serikov1/AutomaticWateringSystem/README.md

# Автоматическая система полива комнатных растений

* [Описание проекта](#chapter-0)
* [Материалы и компоненты](#chapter-1)
* [Схема подключения](#chapter-2)
* [Код проекта](#chapter-3)
* [Тестирование](#chapter-4)
* [Инструкция по эксплуатации (скачать)](#chapter-5)

## Описание проекта
Особенности:
- Возможность полива 2 видов растений с различным потреблением влаги
- Индивидуальная настройка пользователем периода и времени работы системы полива
- Дисплей с отображением пользовательских настроек
- Хранение настроек в энергонезависимой памяти
- Управление и настройка энкодером и кнопкой

## Материалы и компоненты

| Компоненты | шт | цена, руб|
| --- |:--:|:---:|
| Пластиковый (PLA) корпус, напечатанный на 3D принтере | 1  | 55 |
| Помпа водяная | 2  | 500 |
| Экран жидкокристаллический (lcd 1602 I2C) | 1  | 200 |
| Энкодер (HC11) | 1  | 100 |
| Микроконтроллер (Arduino Nano ATmega328P) | 1  | 200 |
| Транзистор полевой (IRF1407) | 2  | 20 |
| Резистор 10кΩ | 2  | 10 |
| Резистор 200Ω | 2  | 10 |
| Диод 1N5408 | 2  | 10 |
| Конденсатор электролитический 470uF | 2  | 10 |
| Конденсатор керамический 0,1uF | 1  | 10 |
| Разъем micro-usb | 1  | 50 |
| Плата печатная | 1  | 50 |
| | |Итог: 1225|

## Схема подключения модулей
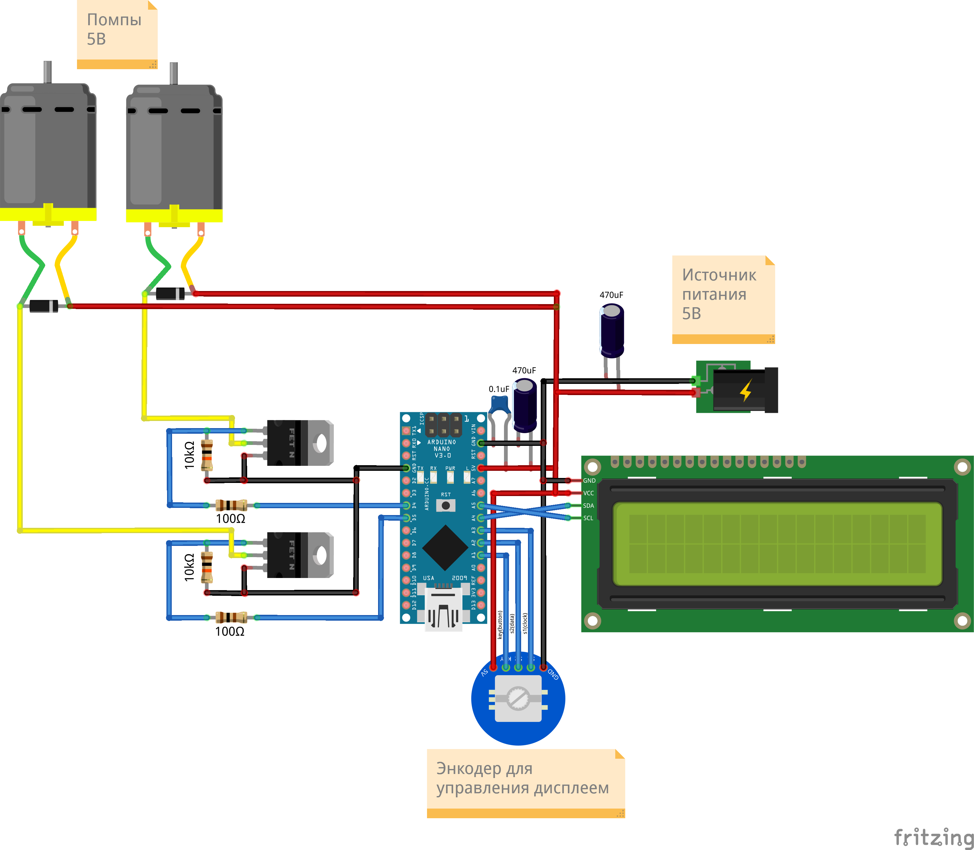
[picture p1: pictures/scheme.png]
SCHEME


### Код проекта смотрите по [ссылке](https://github.com/serikov1/AutomaticWateringSystem/tree/main/src)

### Результаты тестирования (протоколы испытыний) смотрите по [ссылке](https://github.com/serikov1/AutomaticWateringSystem/tree/main/presentation)

### Руководство по эксплуатации обязательно(!) к прочтению по [ссылке](https://github.com/serikov1/AutomaticWateringSystem/raw/main/manual/Automatic%20Watering%20System%20Manual.pdf)
