serikov1/AutomaticWateringSystem/presentation/perfomance.pptx

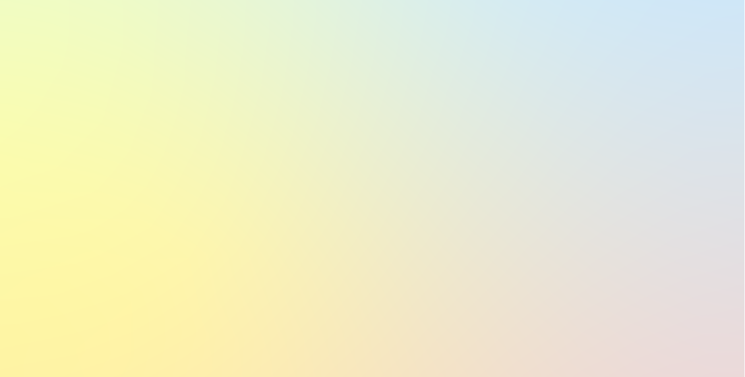
[picture p2: figure]

План создания продукта

Автоматический полив растений

Группа: Б03-102 Студент: Сериков Василий

## Slide 2

Проблемы

1.

Часто забываем поливать домашние растения

2.

Имеем большое количество различных растений

3.

Долгое время находимся вне дома

## Slide 3

Решения

1.

Полив настроенный на определенные промежутки время

2.

Поддержка полива нескольких различных растений

3.

Питание от блока 5В,
использование любой емкости с водой

## Slide 4

Схема устройства

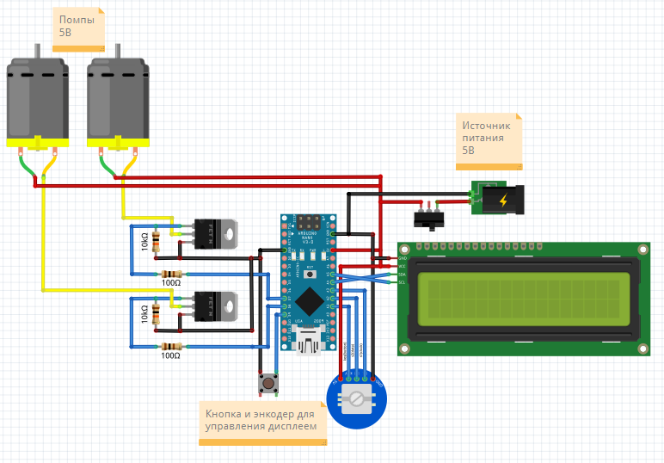
[picture p3: figure]

## Slide 5

Стоимость элементов

1. Arduino Nano ATmega328P – 300 руб.

2. Помпа водяная 2шт.– 500 руб.

3. ЖК экран lcd1602 I2C– 300 руб.

4. Энкодер HC11 – 120 руб.

5. Кнопка тактовая – 9 руб.

6. Mosfet IRF1407 2шт. – 40 руб.

7. Резисторы 10кΩ, 200Ω по 2шт. ~ 10 руб.

8. Переключатель двухпозиционный – 40 руб.

9. Корпус пластиковый ~ 20 руб.

Σ = 1339 руб.

## Slide 6

График работы

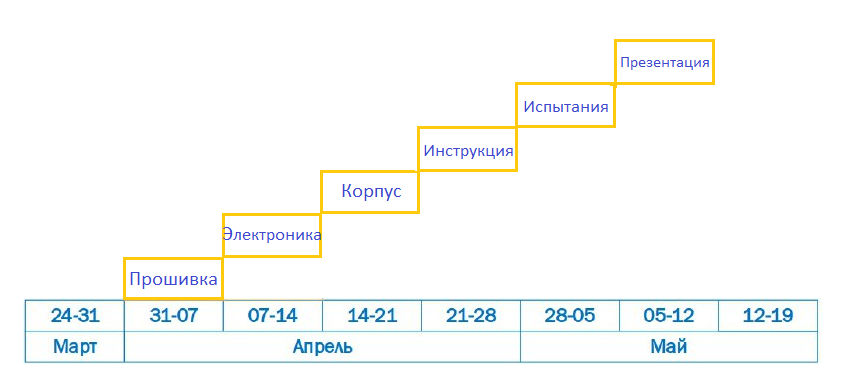
[picture p4: figure]

## Slide 7

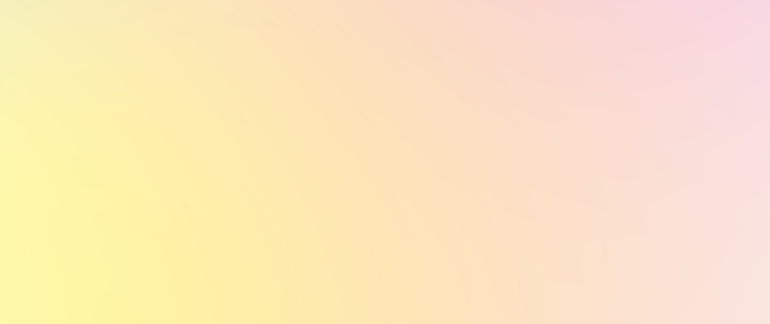
[picture p5: figure]

Спасибо за внимание

Ссылка на репозиторий

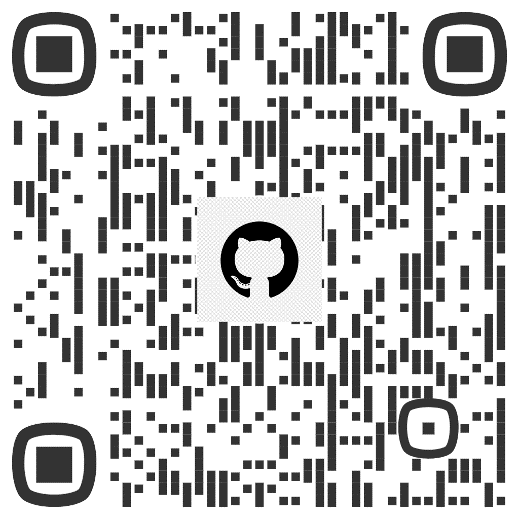
[picture p6: figure]
