serikov1/AutomaticWateringSystem/presentation/протокол испытаний №3.docx

г. Долгопрудный “19” мая 2023 г.

ПРОТОКОЛ ИСПЫТАНИЙ №3

на отказоустойчивость автоматической системы полива

1. Объект: система автоматического полива
2. Заказчик испытания: Сериков Василий
3. Дата изготовления: 7.04.2023 г.
4. Дата испытаний: 4.04.2023 г. – 15.04.2023 г.
5. Число образцов: 1 штука
6. Требования по отказоустойчивости: 10 дней
7. Условия проведения испытаний температурный режим: 25 °C
8. Число циклов работы системы: 10 по 24 часа
9. Фактическое время работы: 10 дней

Выводы: система автоматического полива справилась с испытанием работы в течении 10 дней.

Независимый эксперт Потылицын Иван
