serikov1/AutomaticWateringSystem/presentation/протокол испытаний №1.docx

г. Долгопрудный “15” мая 2023 г.

ПРОТОКОЛ ИСПЫТАНИЙ №1

на отказоустойчивость автоматической системы полива

1. Объект: система автоматического полива
2. Заказчик испытания: Сериков Василий
3. Дата изготовления: 7.04.2023 г.
4. Дата испытаний: 14.04.2023 г. – 21.04.2023 г.
5. Число образцов: 1 штука
6. Требования по отказоустойчивости: 24, 48 часа
7. Условия проведения испытаний температурный режим: 25 °C
8. Число циклов работы системы: 3
9. Фактическое время работы: 24 часа

Выводы: Система автоматического полива не справилась с испытанием работы 48 часа, но справилась с 24 часами работы.

Независимый эксперт Шувайникова Татьяна.
