serikov1/AutomaticWateringSystem/presentation/протокол испытаний №2.docx

г. Долгопрудный “15” мая 2023 г.

ПРОТОКОЛ ИСПЫТАНИЙ №2

на отказоустойчивость автоматической системы полива

1. Объект: система автоматического полива
2. Заказчик испытания: Сериков Василий
3. Дата изготовления: 7.04.2023 г.
4. Дата испытаний: 22.04.2023 г. – 2.05.2023 г.
5. Число образцов: 1 штука
6. Требования по отказоустойчивости: 24, 48, 72 часа
7. Условия проведения испытаний температурный режим: 25 °C
8. Число циклов работы системы: 3
9. Фактическое время работы: 24, 48, 72 часа

Выводы: Система автоматического полива справилась с испытанием работы 24, 48, 72 часа

Независимый эксперт Сериков Алексей.
