serikov1/AutomaticWateringSystem/presentation/first protection.pptx

Презентация макета

Автоматический полив растений

Группа: Б03-102 Студент: Сериков Василий

## Slide 2

Выполненные задачи

1.

Разработка прошивки

2.

Создание корпуса

3.

Сборка схемы

## Slide 3

Оставшиеся задачи

1.

Доработка корпуса

2.

Написание инструкции

3.

Тестирование

## Slide 4


Спасибо за внимание

Ссылка на репозиторий
