serikov1/AutomaticWateringSystem/body model/fourth model/3.png

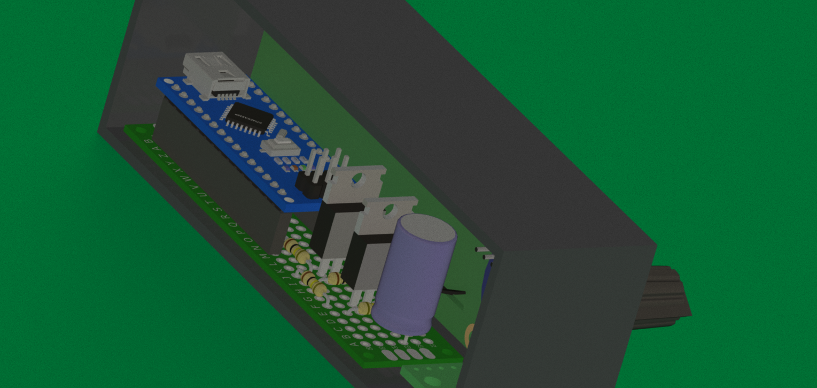
body model/fourth model/3.png
