serikov1/AutomaticWateringSystem/body model/fourth model/4.png

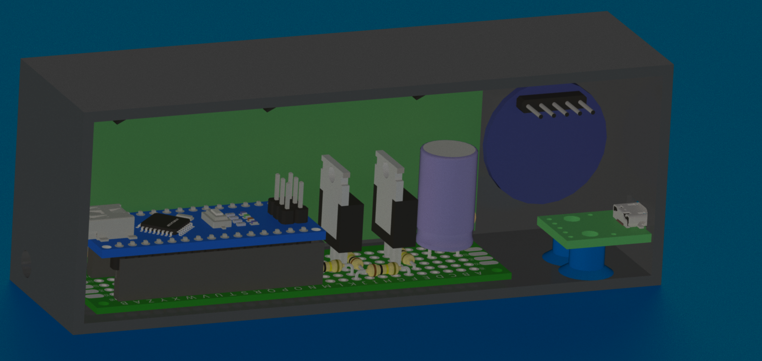
body model/fourth model/4.png
