serikov1/AutomaticWateringSystem/body model/fourth model/5.png

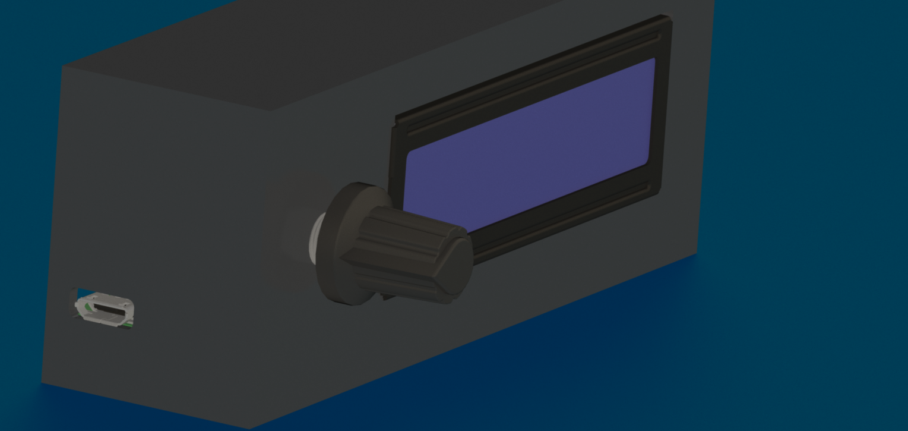
body model/fourth model/5.png
