serikov1/AutomaticWateringSystem/body model/fourth model/6.png

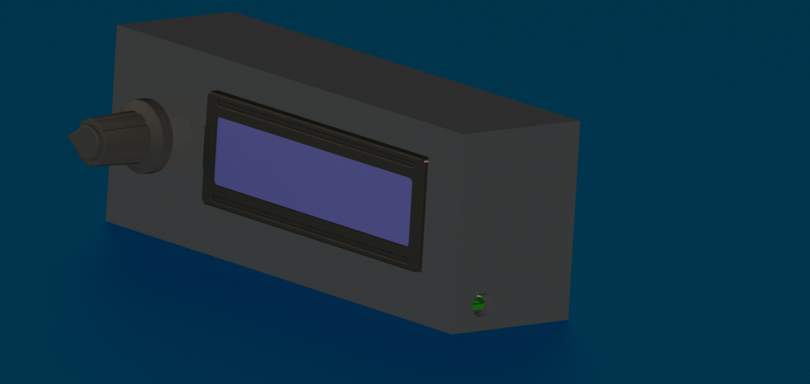
body model/fourth model/6.png
