serikov1/AutomaticWateringSystem/body model/fourth model/7.png

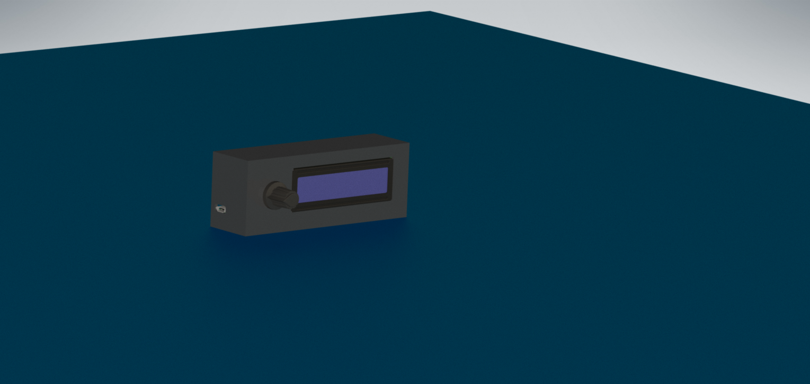
body model/fourth model/7.png
