serikov1/AutomaticWateringSystem/body model/fourth model/8.png

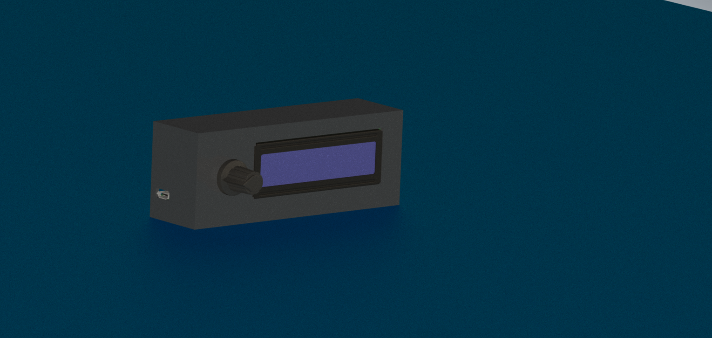
body model/fourth model/8.png
