serikov1/AutomaticWateringSystem/body model/fourth model/9.png

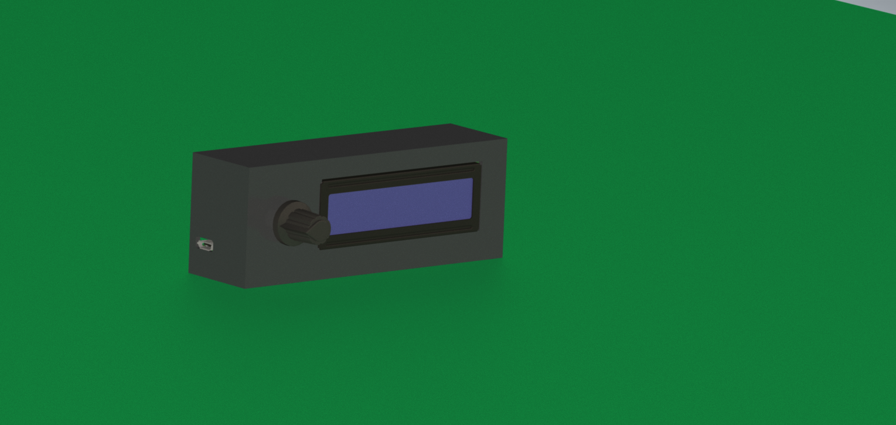
body model/fourth model/9.png
