serikov1/AutomaticWateringSystem/body model/fourth model/10.png

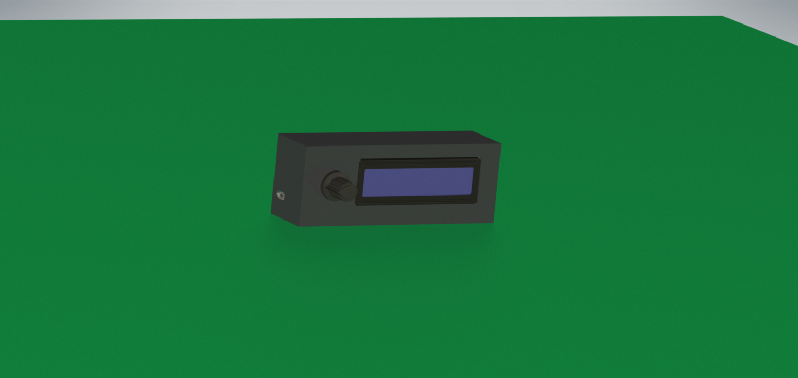
body model/fourth model/10.png
