serikov1/AutomaticWateringSystem/body model/fourth model/body model 2.png

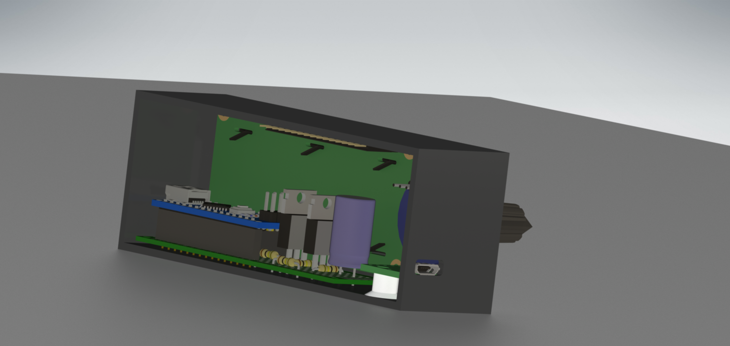
body model/fourth model/body model 2.png
