serikov1/AutomaticWateringSystem/body model/fourth model/body model.png

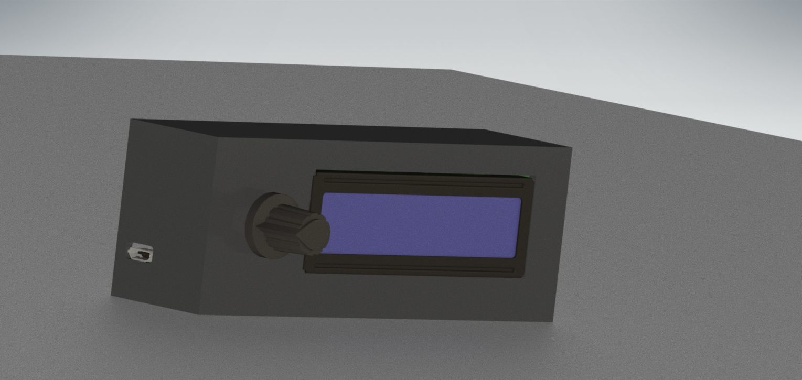
body model/fourth model/body model.png
