serikov1/AutomaticWateringSystem/presentation/pict/first plan.png

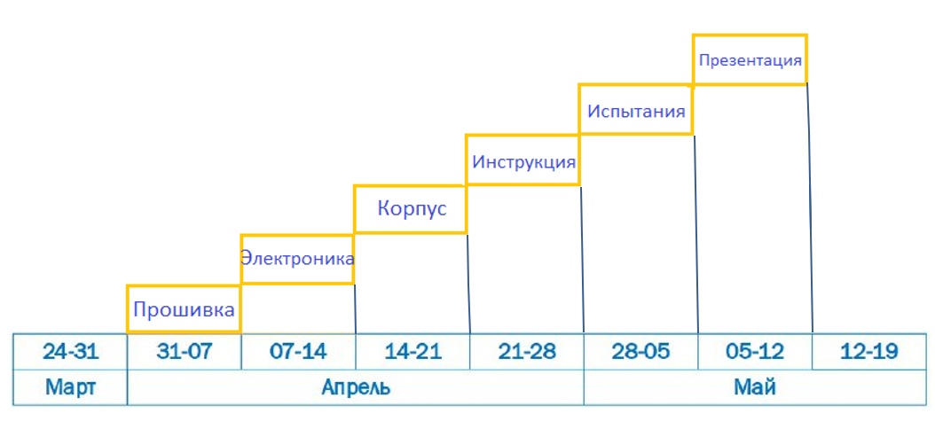
presentation/pict/first plan.png
