serikov1/AutomaticWateringSystem/presentation/pict/photo1684565055.jpeg

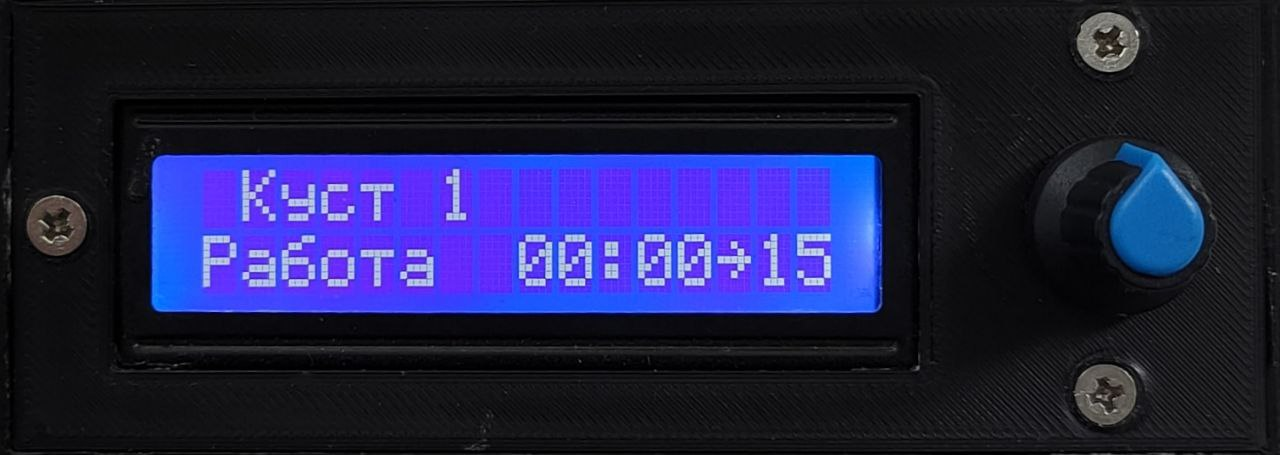
presentation/pict/photo1684565055.jpeg
