serikov1/AutomaticWateringSystem/presentation/pict/pict2 short.png

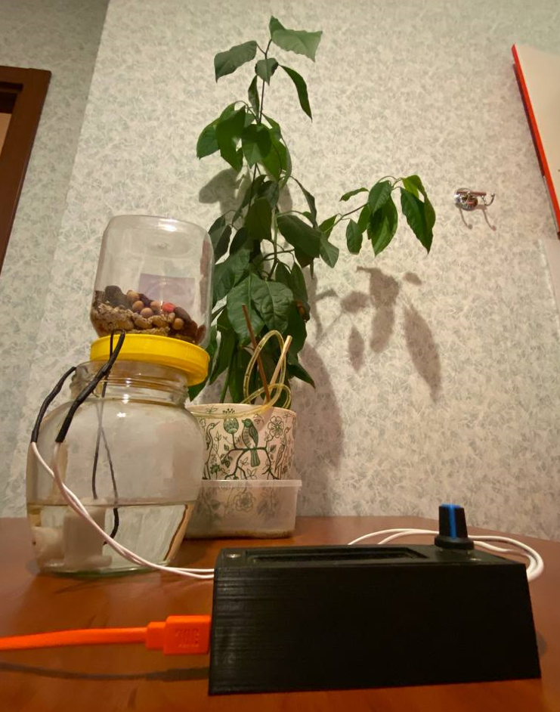
presentation/pict/pict2 short.png
