serikov1/AutomaticWateringSystem/presentation/pict/second plan.png

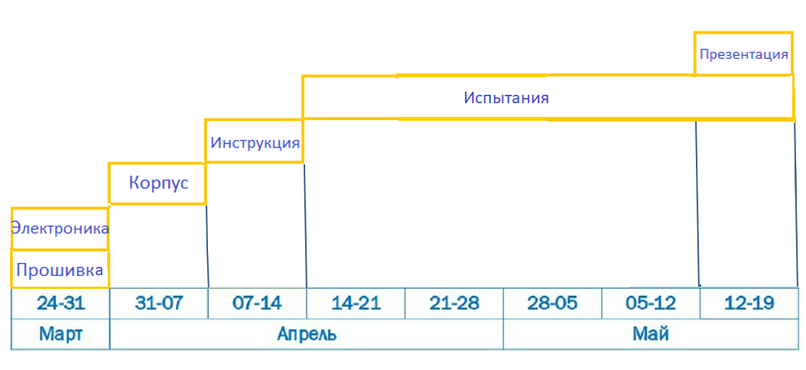
presentation/pict/second plan.png
