serikov1/AutomaticWateringSystem/presentation/pict/wall1.jpg

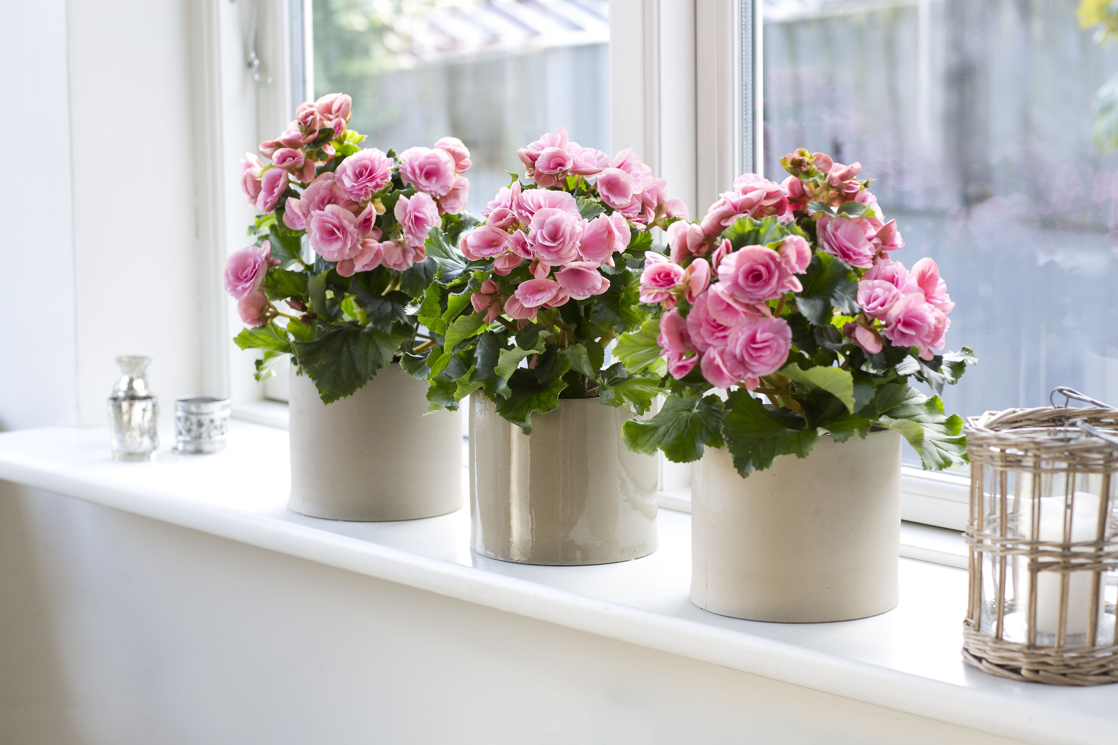
presentation/pict/wall1.jpg
