serikov1/AutomaticWateringSystem/presentation/pict/wall2.jpg

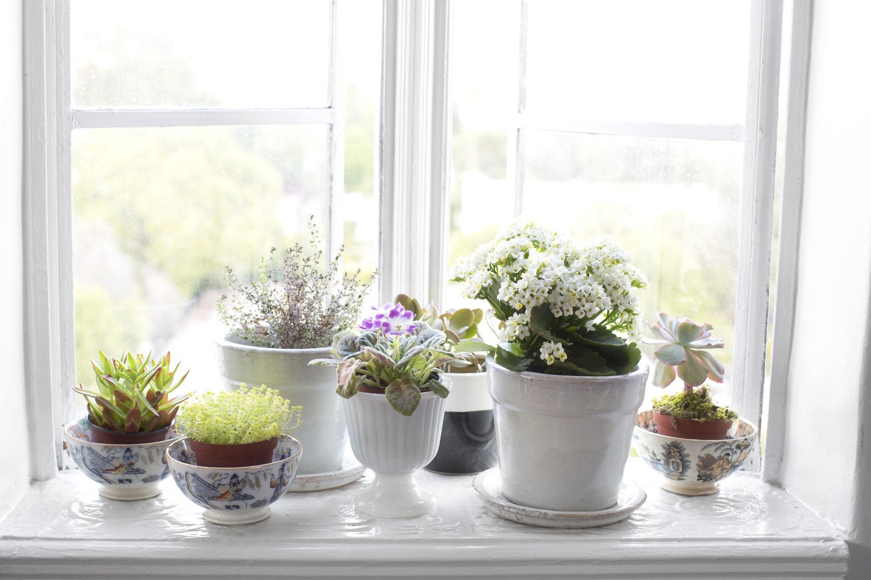
presentation/pict/wall2.jpg
