serikov1/AutomaticWateringSystem/presentation/pict/wall.jpg

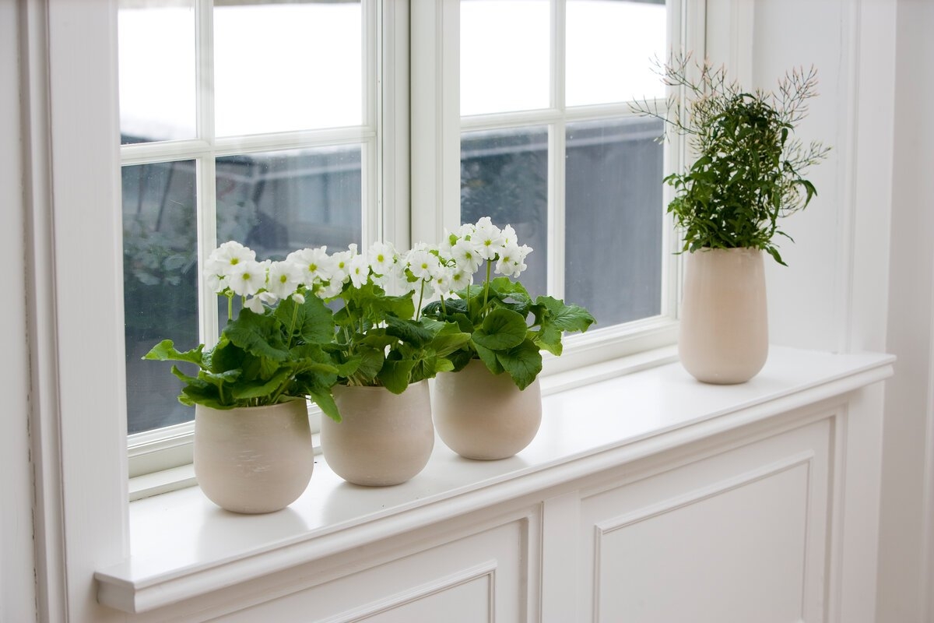
presentation/pict/wall.jpg
