serikov1/AutomaticWateringSystem/body model/first model/body model.3mf

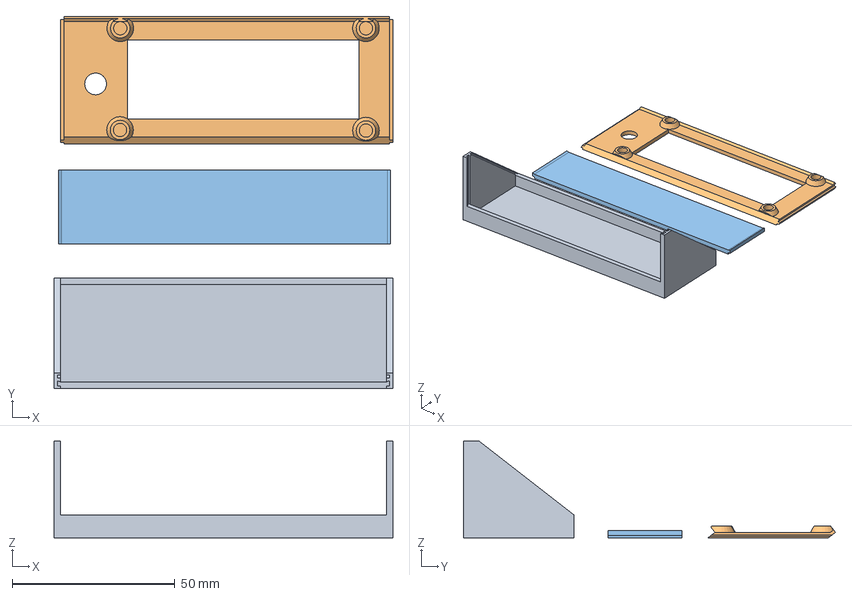
[picture p25: CAD file, 2023-04-11]
body model/first model/body model.3mf
104.0 x 114.2 x 29.7 mm
2 Булева_13.stl
3 Булева_15.stl
1 Выталкивание_6.stl
