serikov1/AutomaticWateringSystem/body model/fourth model/2 Булева_19.stl

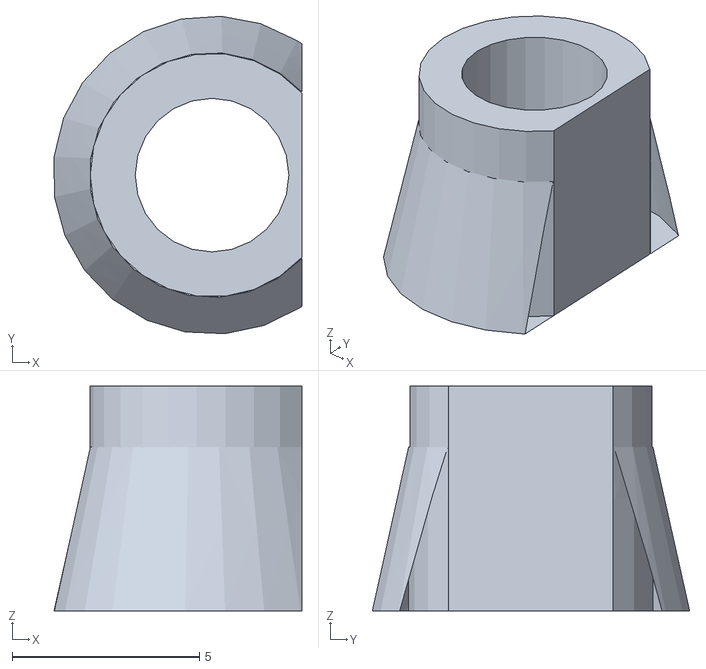
[picture p26: CAD file, 2023-04-19]
body model/fourth model/2 Булева_19.stl
6.62 x 8.47 x 6.00
