serikov1/AutomaticWateringSystem/body model/second model/2 Булева_15.stl

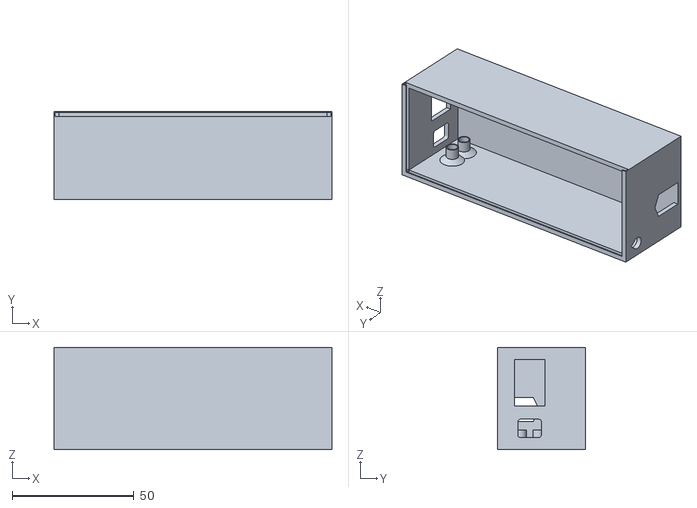
[picture p27: CAD file, 2023-04-11]
body model/second model/2 Булева_15.stl
114.0 x 36.0 x 42.0
