serikov1/AutomaticWateringSystem/body model/third model/2 Булева_17.stl

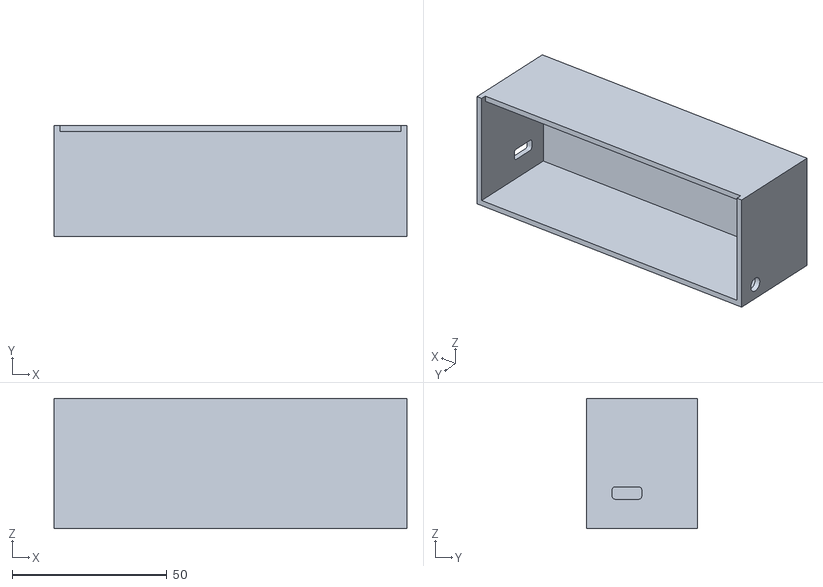
[picture p28: CAD file, 2023-04-11]
body model/third model/2 Булева_17.stl
114.0 x 36.0 x 42.0
