serikov1/AutomaticWateringSystem/body model/first model/2 Булева_13.stl

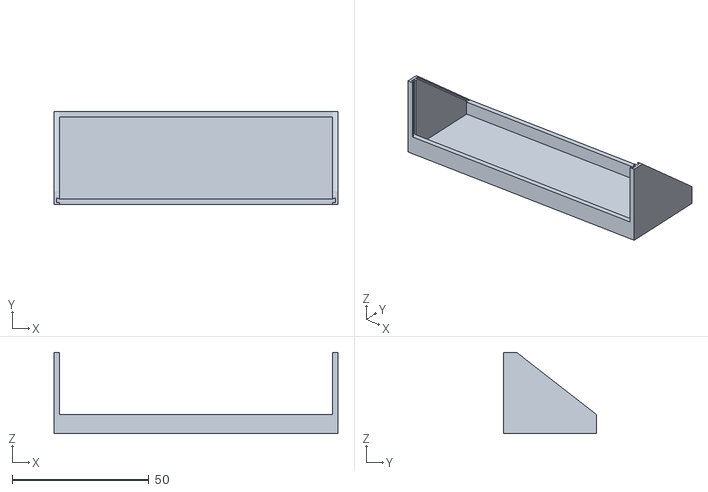
[picture p29: CAD file, 2023-04-11]
body model/first model/2 Булева_13.stl
104.0 x 34.0 x 29.7
