serikov1/AutomaticWateringSystem/body model/fourth model/body model.stl

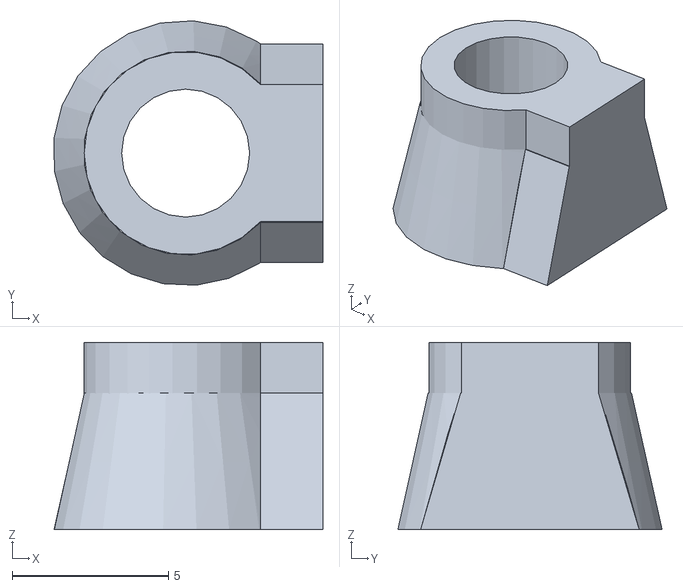
[picture p30: CAD file, 2023-04-19]
body model/fourth model/body model.stl
8.62 x 8.47 x 6.00
