serikov1/AutomaticWateringSystem/body model/second model/second model.3mf

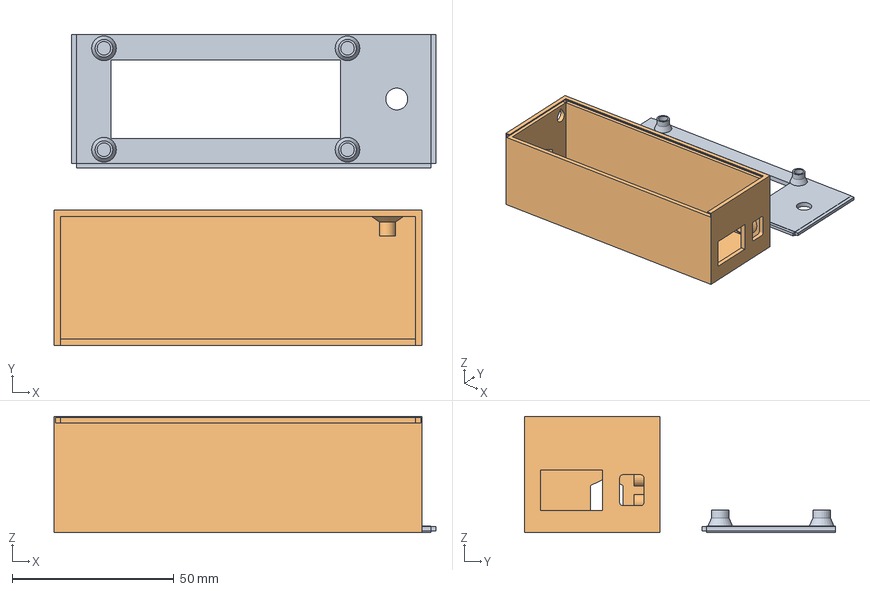
[picture p31: CAD file, 2023-04-11]
body model/second model/second model.3mf
118.3 x 96.3 x 36.0 mm
1 Булева_11.stl
2 Булева_15.stl
