serikov1/AutomaticWateringSystem/body model/third model/5 Булева_19.stl

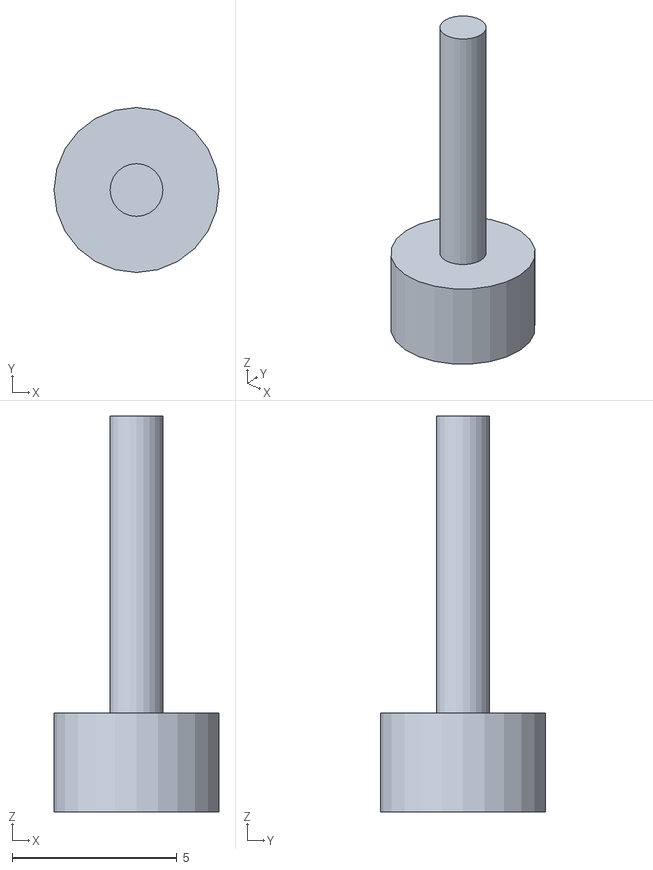
[picture p32: CAD file, 2023-04-11]
body model/third model/5 Булева_19.stl
5.00 x 5.00 x 12.0
