serikov1/AutomaticWateringSystem/body model/first model/3 Булева_15.stl

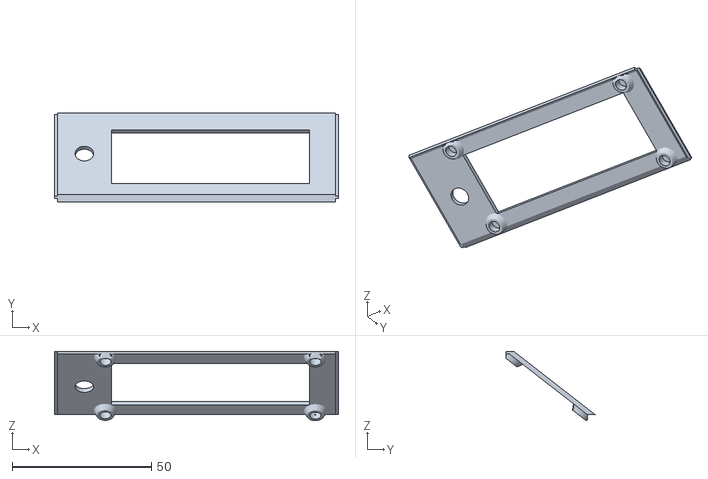
[picture p33: CAD file, 2023-04-11]
body model/first model/3 Булева_15.stl
102.0 x 32.0 x 24.9
