serikov1/AutomaticWateringSystem/body model/fourth model/3 Булева_21.stl

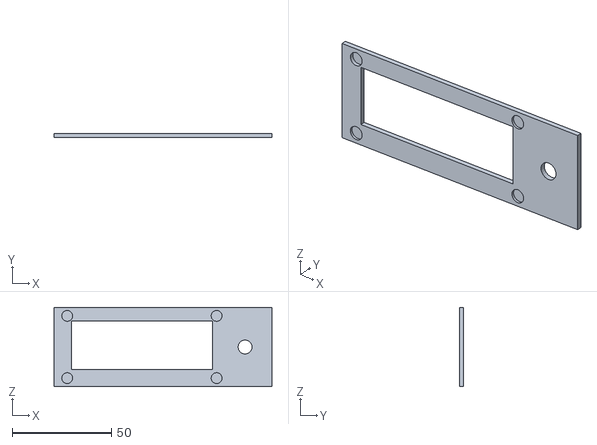
[picture p34: CAD file, 2023-04-19]
body model/fourth model/3 Булева_21.stl
110.0 x 2.00 x 40.0
