serikov1/AutomaticWateringSystem/body model/second model/1 Булева_11.stl

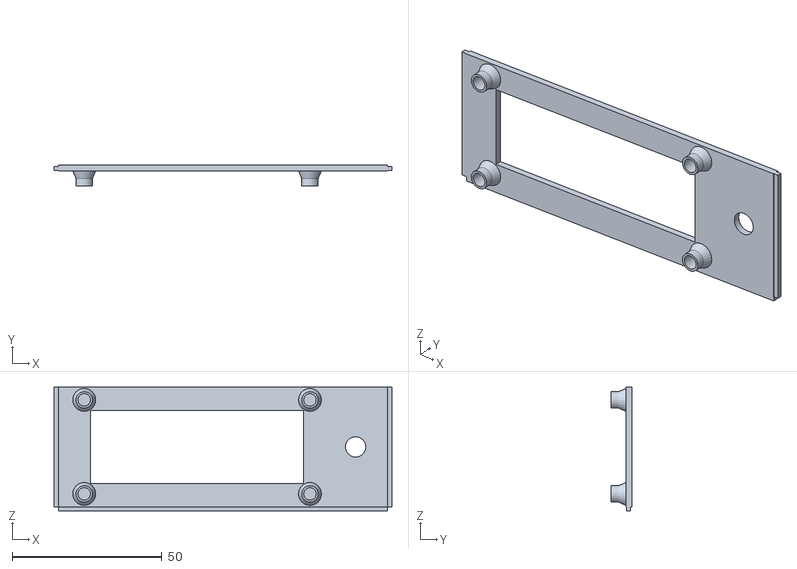
[picture p35: CAD file, 2023-04-11]
body model/second model/1 Булева_11.stl
112.9 x 7.00 x 41.4
