serikov1/AutomaticWateringSystem/body model/third model/1 Булева_15.stl

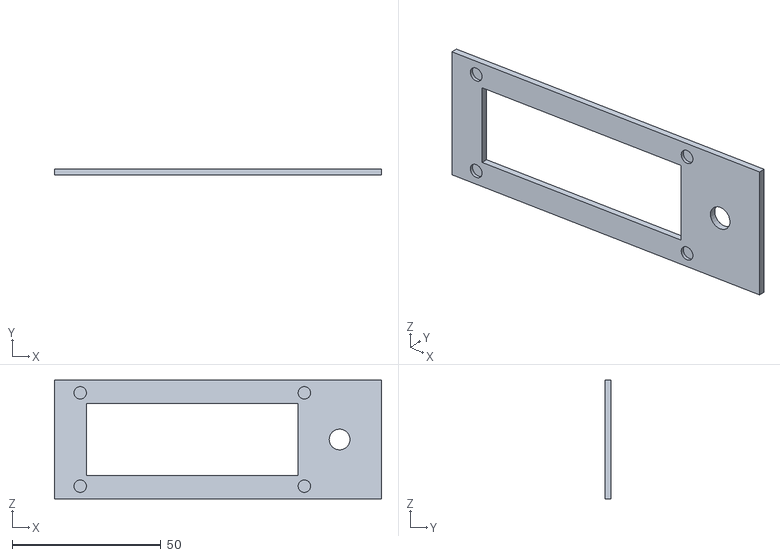
[picture p36: CAD file, 2023-04-11]
body model/third model/1 Булева_15.stl
110.0 x 2.00 x 40.0
