serikov1/AutomaticWateringSystem/body model/first model/1 Выталкивание_6.stl

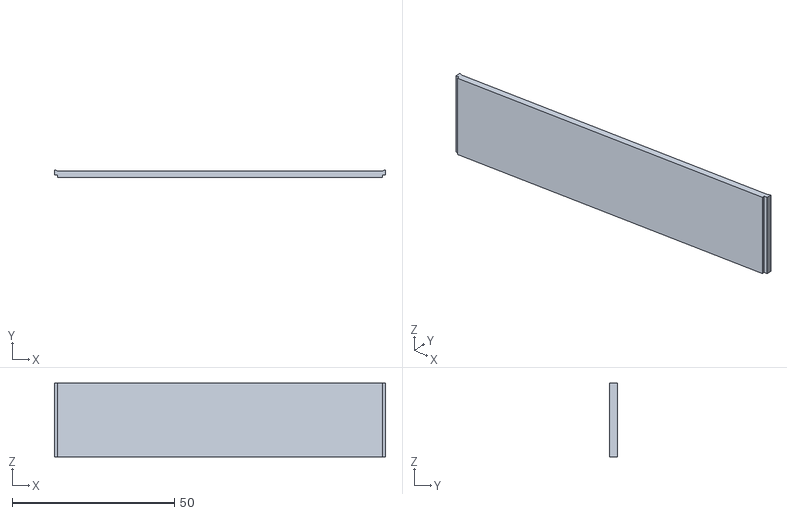
[picture p37: CAD file, 2023-04-11]
body model/first model/1 Выталкивание_6.stl
101.9 x 2.34 x 22.7
