serikov1/AutomaticWateringSystem/body model/fourth model/1 Булева_18.stl

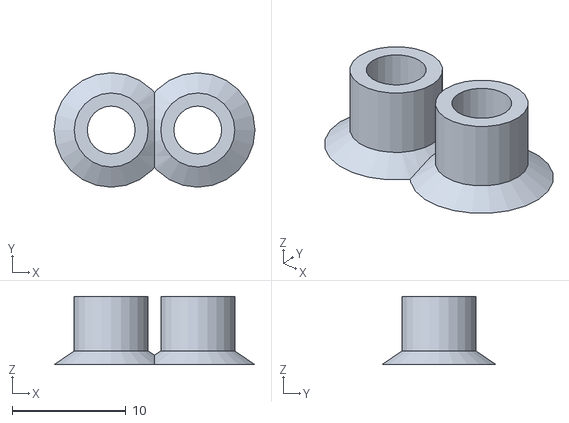
[picture p38: CAD file, 2023-04-11]
body model/fourth model/1 Булева_18.stl
17.6 x 10.0 x 6.00
