serikov1/AutomaticWateringSystem/body model/third model/4 Булева_16.stl

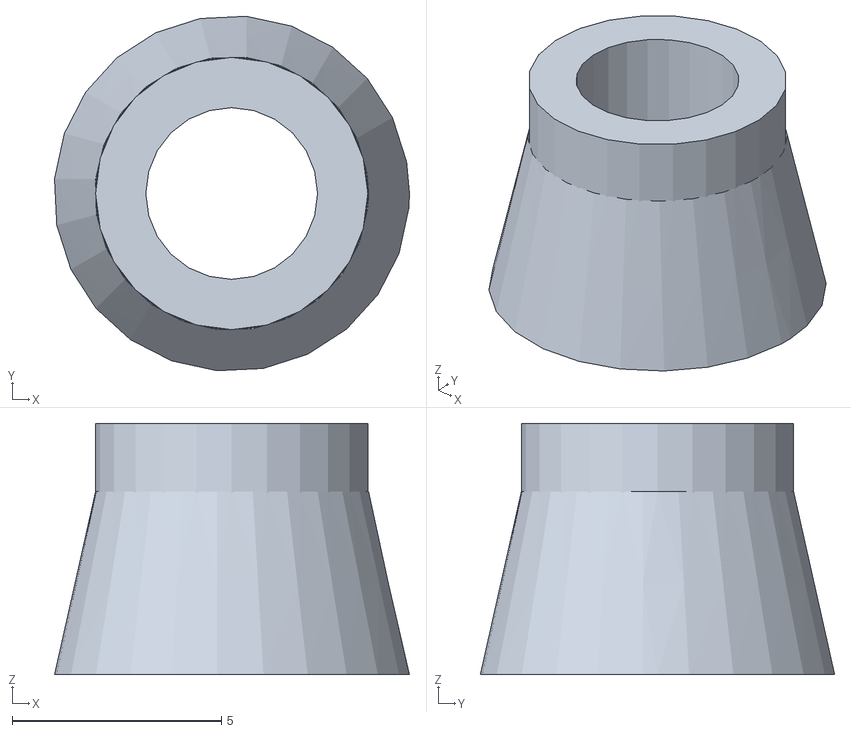
[picture p39: CAD file, 2023-04-11]
body model/third model/4 Булева_16.stl
8.47 x 8.46 x 6.00
