serikov1/AutomaticWateringSystem/(list of files, drawings)

Other design files:
pictures/scheme.fzz
