serikov1/AutomaticWateringSystem/(commit log)

2023-03-25 first commit
    Add the script with initialization some important parts. Also add scheme with modules.
    [scheme.fzz]
2023-03-27 add smt
    [scheme.fzz]
2023-03-27 update scheme and main script
    [scheme.fzz]
2023-03-27 replace scheme.fzz
    [scheme.fzz]
2023-03-30 update scheme and add presentation
    [scheme.fzz]
2023-03-30 update scheme
    [scheme.fzz]
2023-04-03 refactor code and update scheme
    [scheme.fzz]
2023-04-11 made body model update scheme and refactor main script
    [1 Булева_11.stl, 1 Булева_15.stl, 1 Выталкивание_6.stl, 2 Булева_13.stl, 2 Булева_15.stl, 2 Булева_17.stl, 3 Булева_15.stl, 3 Булева_18.stl]
2023-04-11 add gitignore
    [scheme.fzz]
2023-04-19 update manual and body model
    [1 Булева_18.stl, 2 Булева_19.stl, 3 Булева_21.stl, body model.stl]
